kyllikki/SAP/sap.pdf

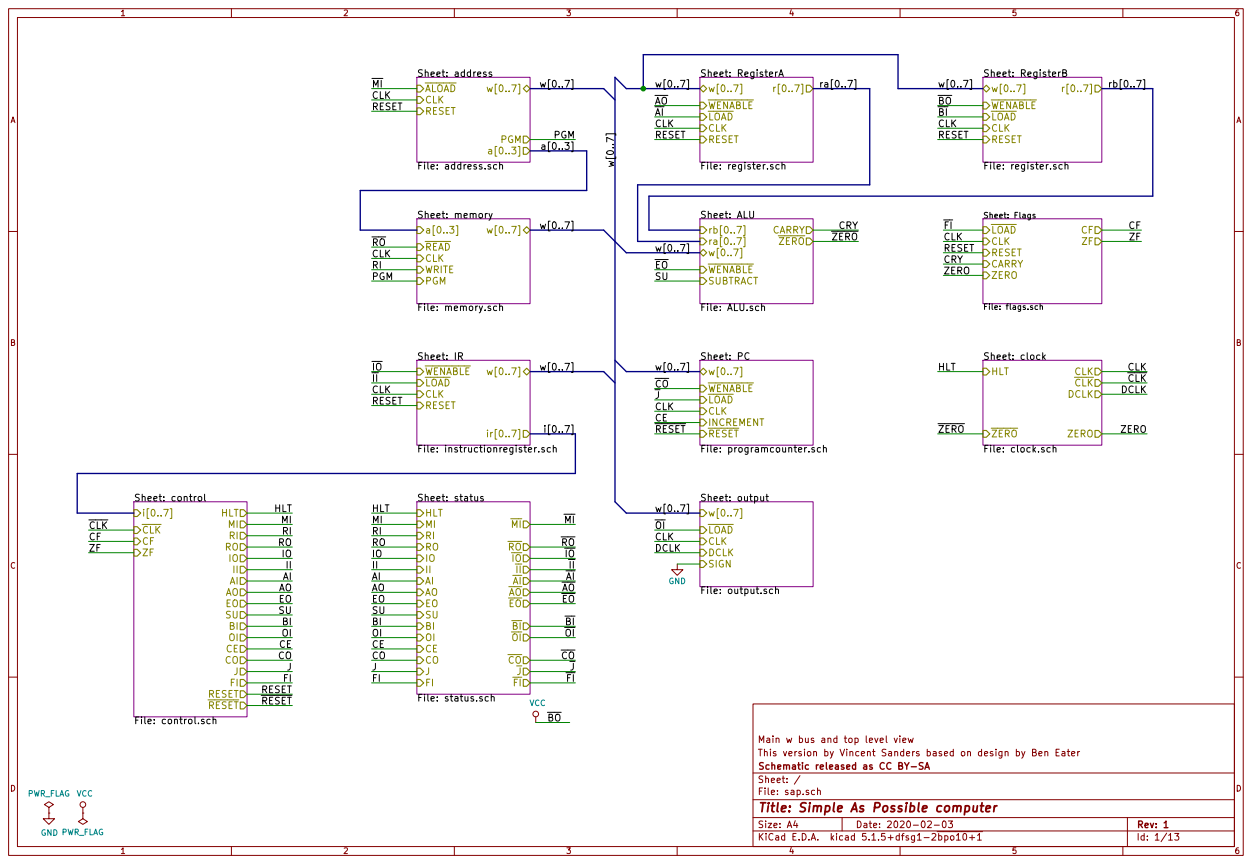
[picture p1: page 1]

Sheet: address File: address.sch w[0..7]
ALOAD
CLK
RESET

ZF Sheet: ALU
File: ALU.sch SUBTRACT WENABLE w[0..7]

Sheet: control File: control.sch CLK

Main w bus and top level view
This version by Vincent Sanders based on design by Ben Eater
File: sap.sch Sheet: / Schematic released as CC BY-SA

Id: 1/13 Title: Simple As Possible computer

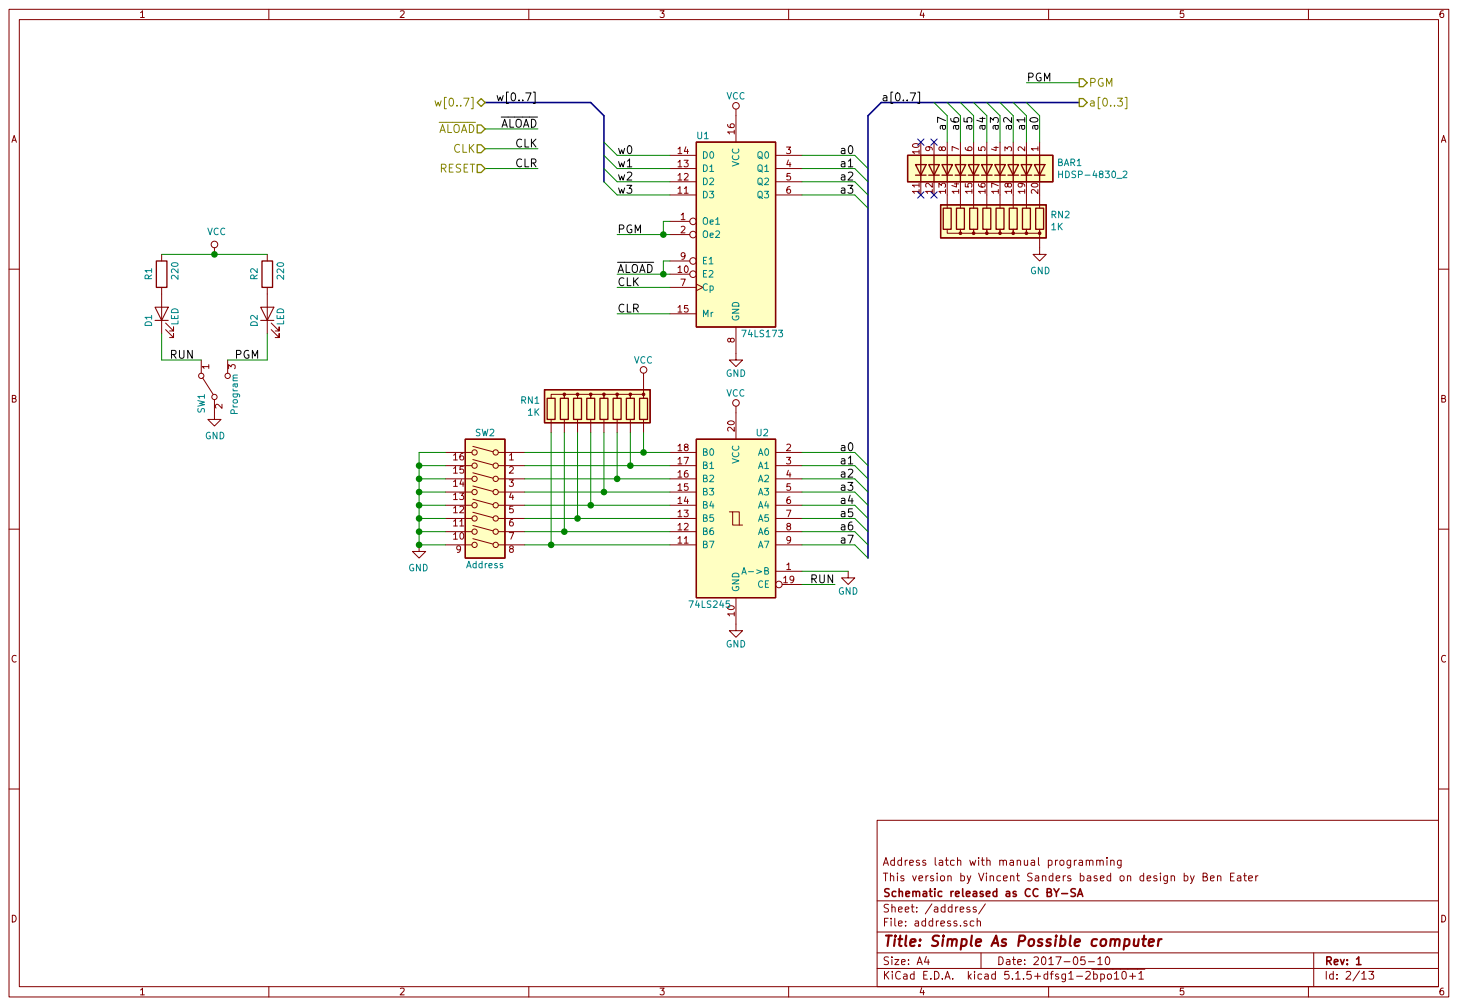
[picture p2: page 2]

Address latch with manual programming GND

This version by Vincent Sanders based on design by Ben Eater
Id: 2/13 Title: Simple As Possible computer File: address.sch Sheet: /address/ Schematic released as CC BY-SA

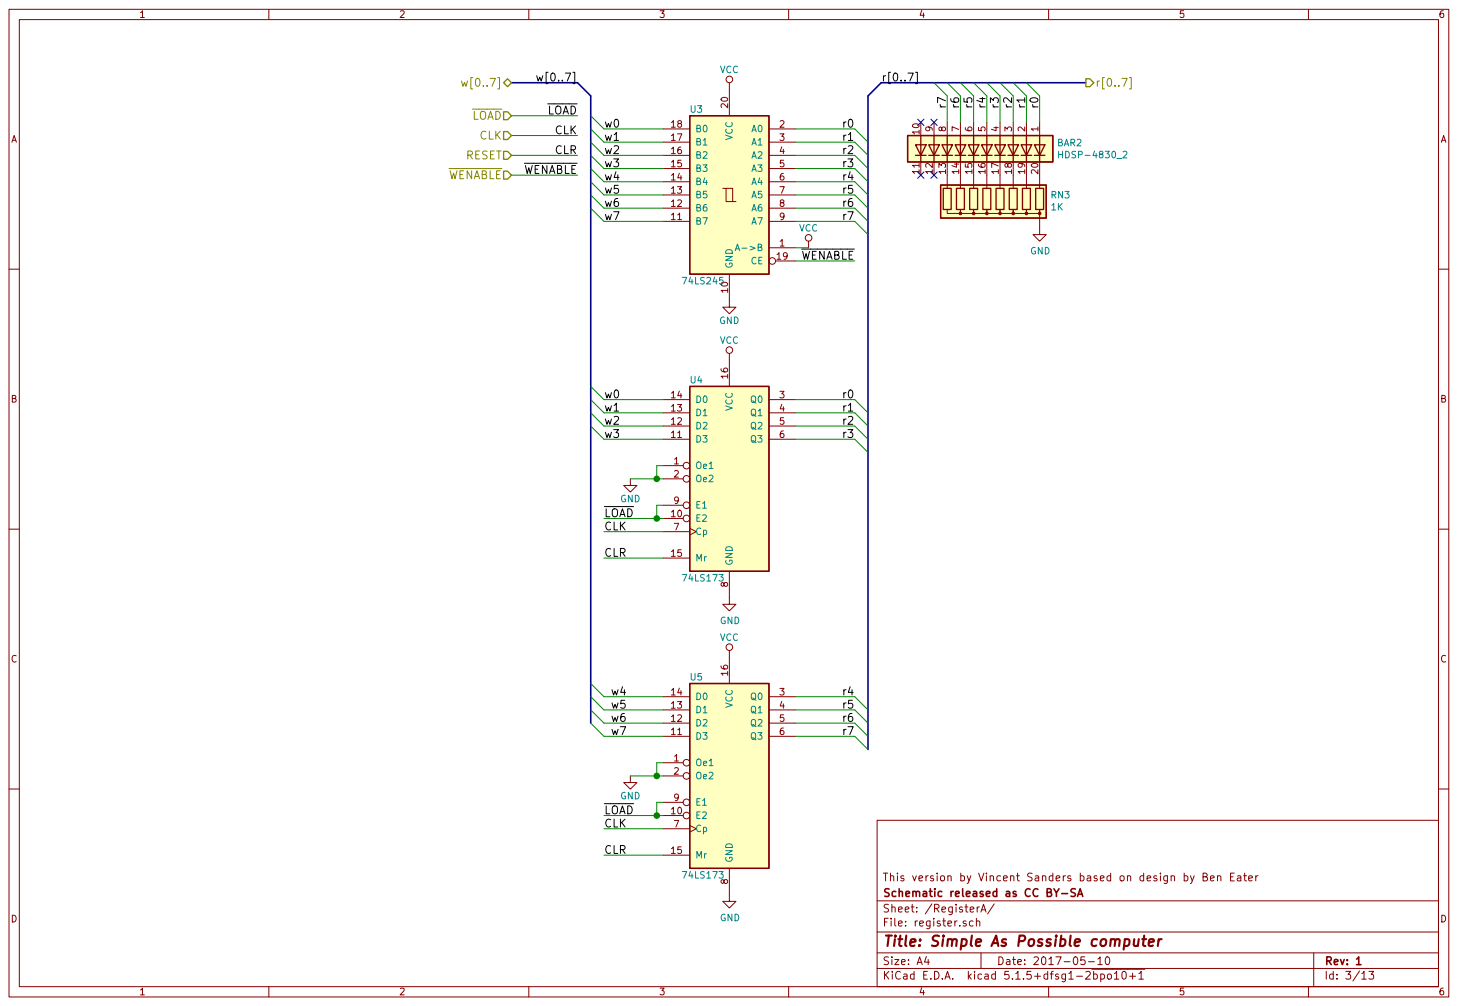
[picture p3: page 3]

Sheet: /RegisterA/ Schematic released as CC BY-SA

File: register.sch
Id: 3/13 Title: Simple As Possible computer

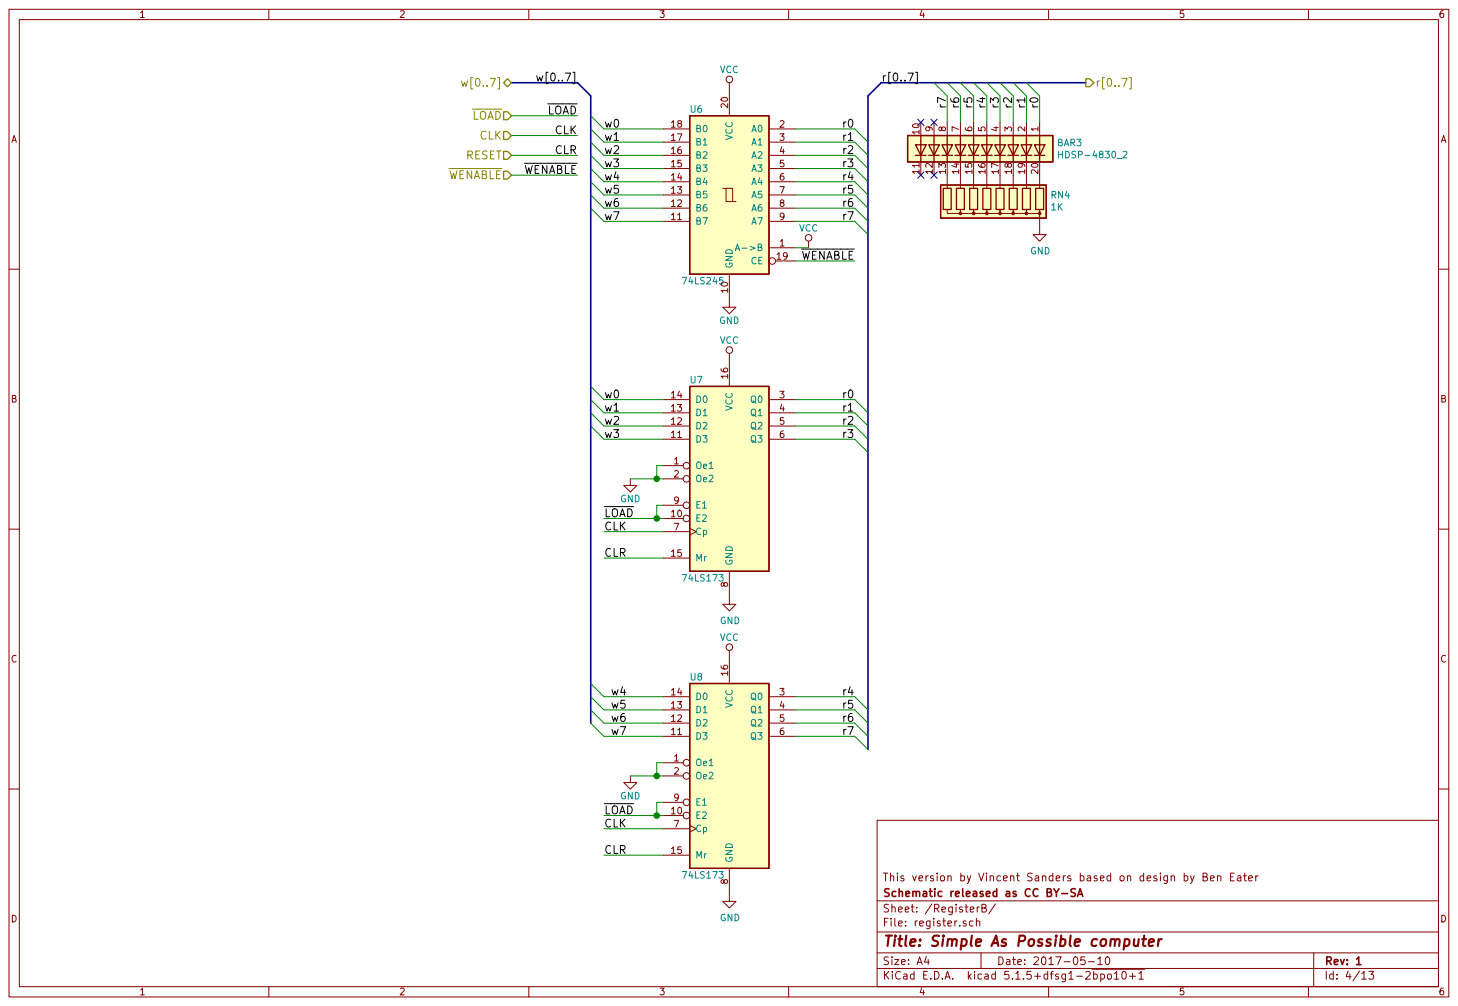
[picture p4: page 4]

Sheet: /RegisterB/ Schematic released as CC BY-SA

File: register.sch
Id: 4/13 Title: Simple As Possible computer

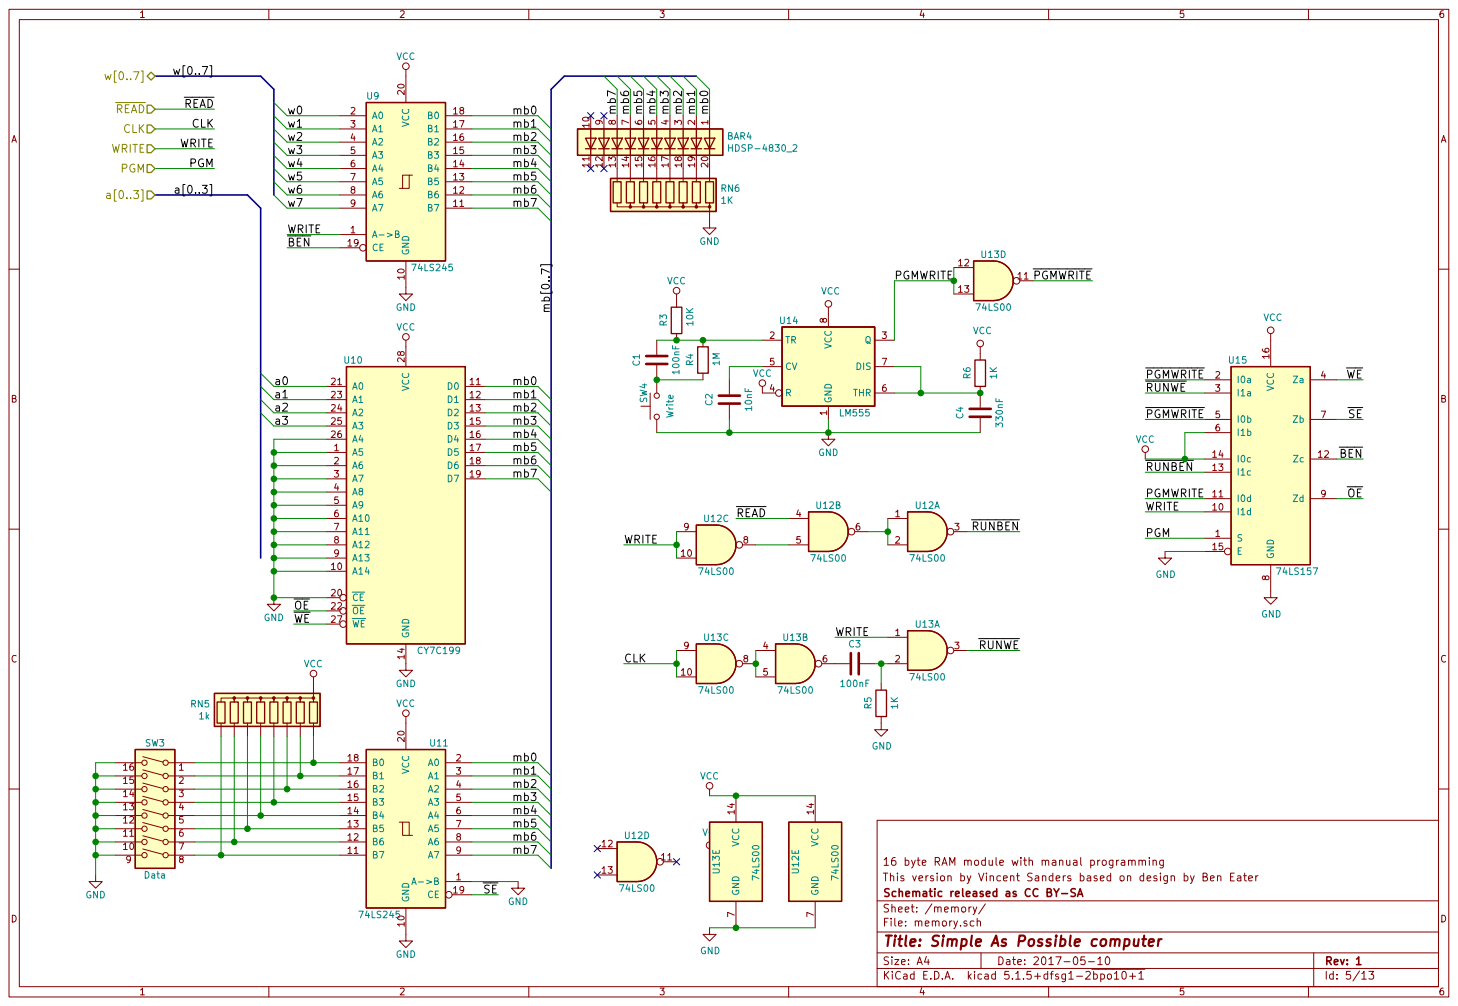
[picture p5: page 5]

This version by Vincent Sanders based on design by Ben Eater
Sheet: /memory/ Schematic released as CC BY-SA

File: memory.sch
Id: 5/13 Title: Simple As Possible computer

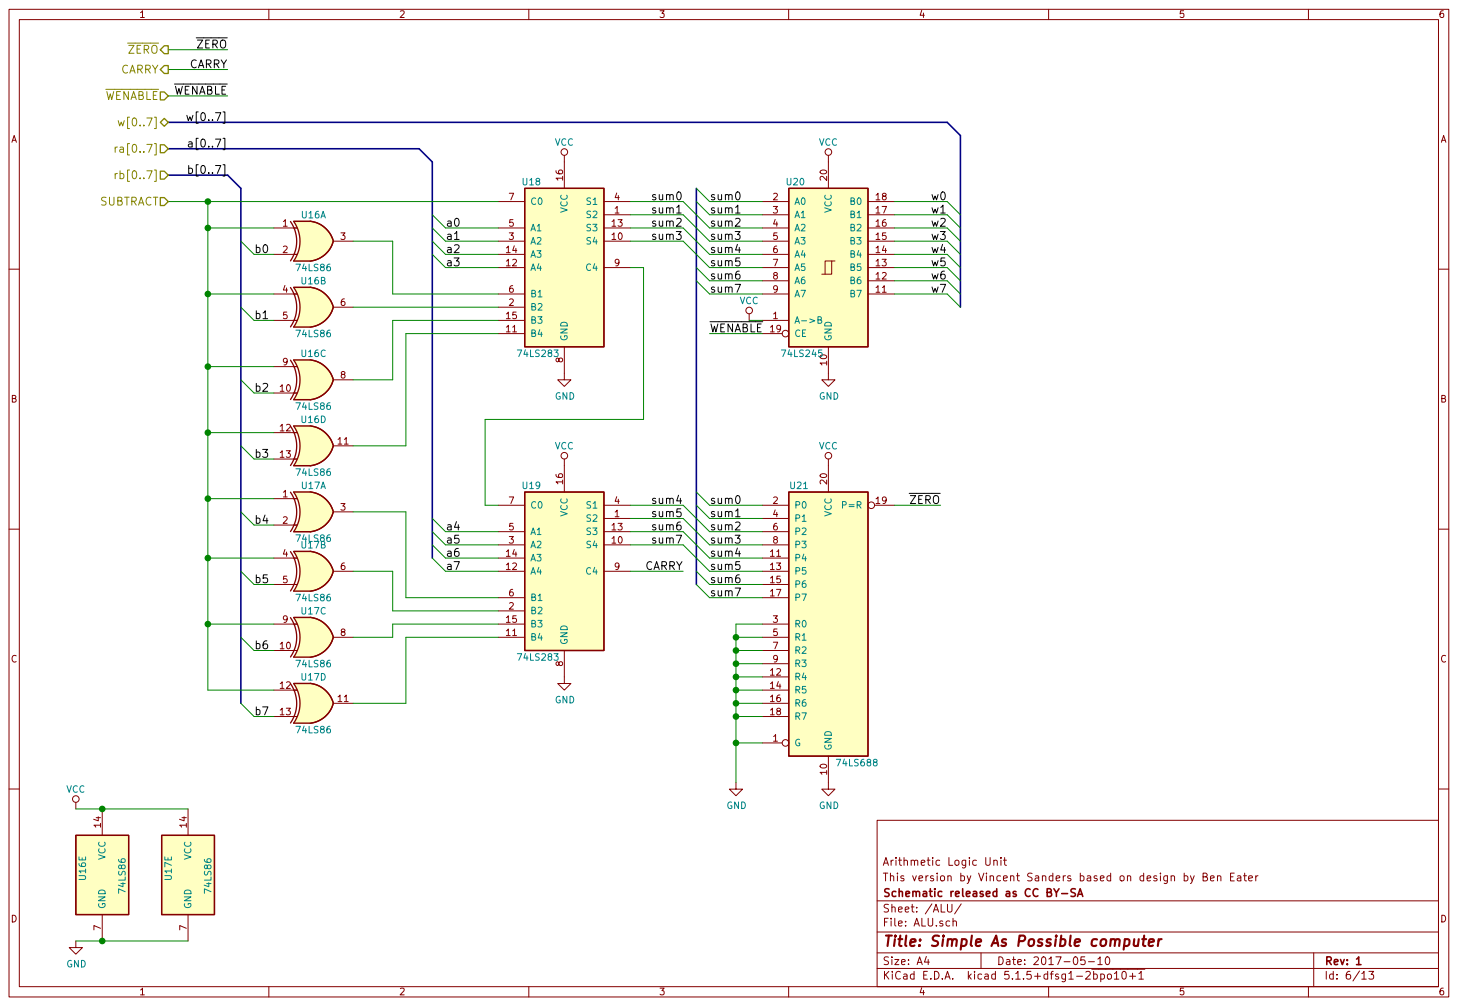
[picture p6: page 6]

This version by Vincent Sanders based on design by Ben Eater
Id: 6/13 Title: Simple As Possible computer File: ALU.sch Sheet: /ALU/ Schematic released as CC BY-SA

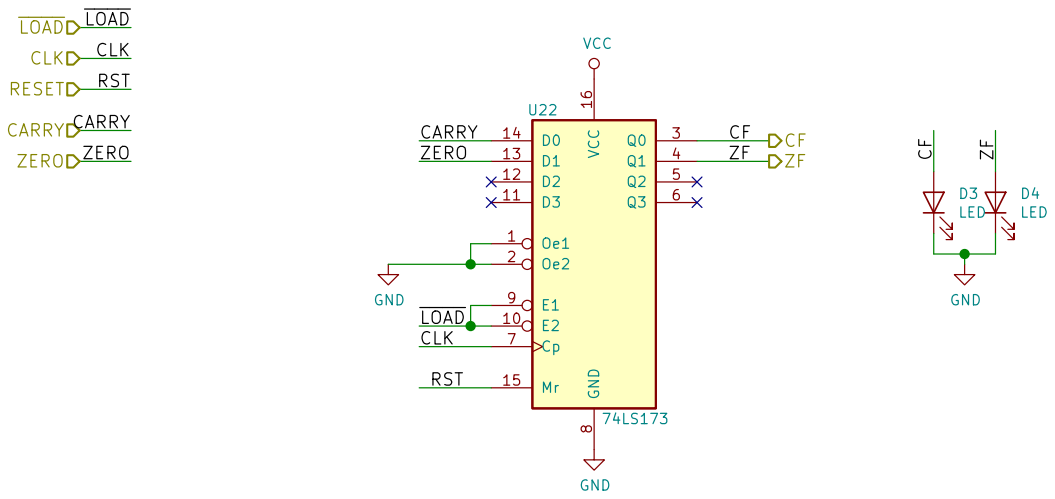
[picture p7: page 7]

Flags register
This version by Vincent Sanders based on design by Ben Eater
Sheet: /Flags/ Schematic released as CC BY-SA

File: flags.sch
Id: 7/13 Title: Simple As Possible computer

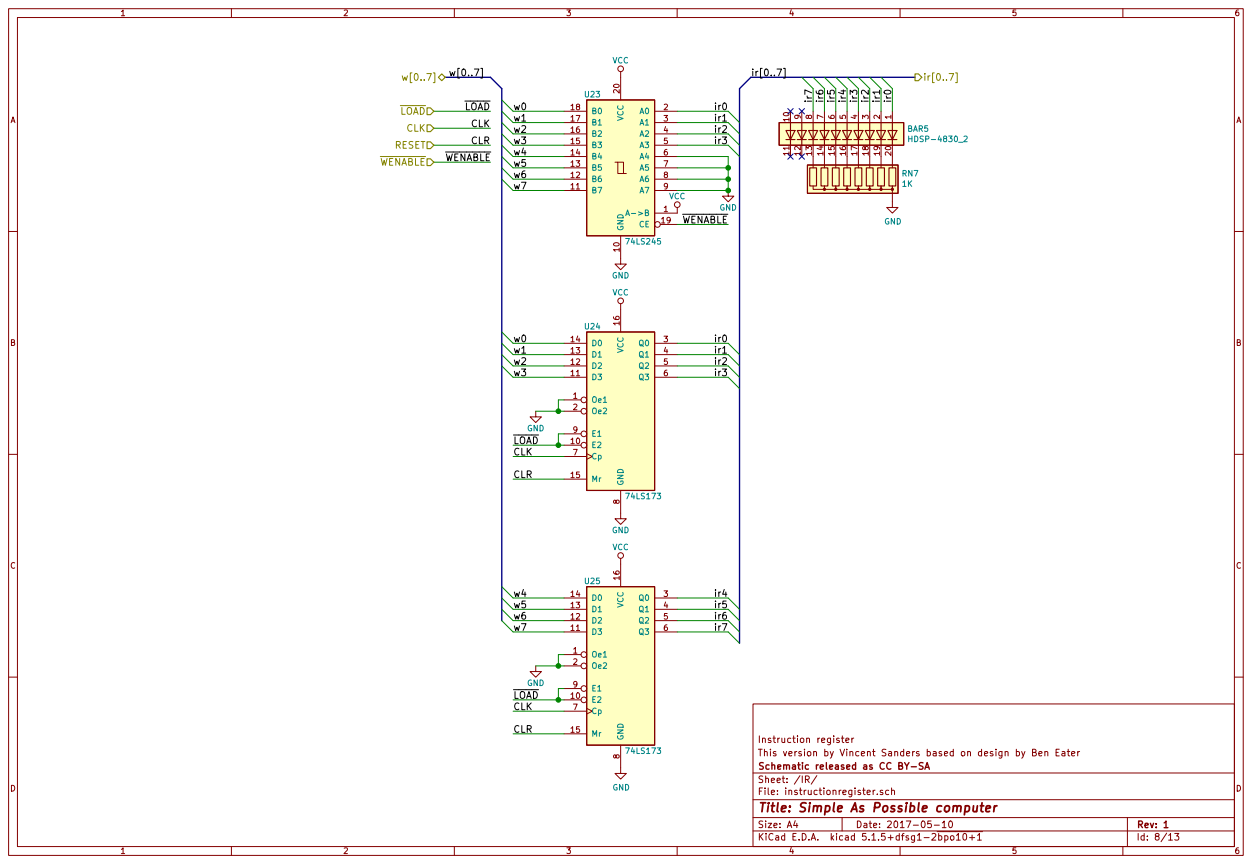
[picture p8: page 8]

Instruction register
This version by Vincent Sanders based on design by Ben Eater
File: instructionregister.sch Sheet: /IR/ Schematic released as CC BY-SA

Id: 8/13 Title: Simple As Possible computer

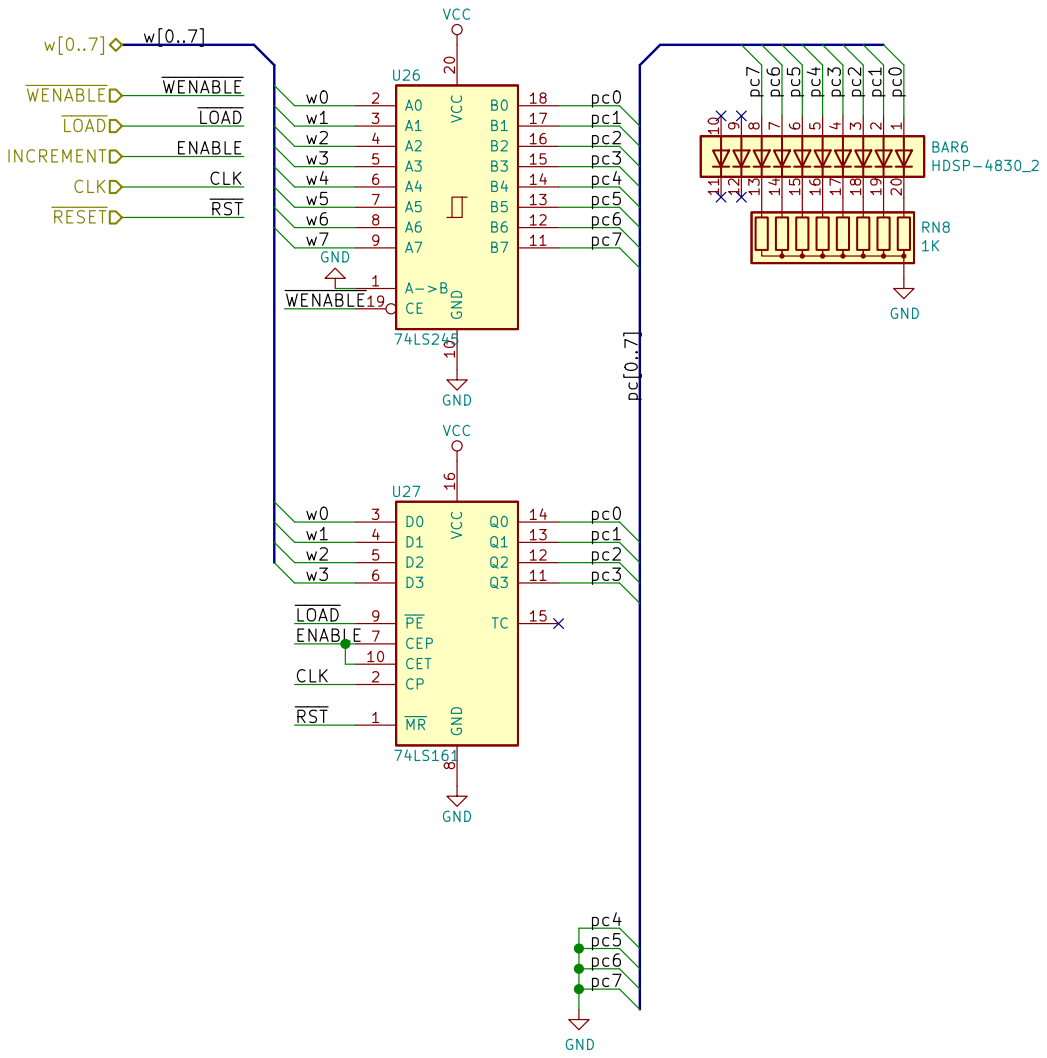
[picture p9: page 9]

Program counter
This version by Vincent Sanders based on design by Ben Eater
File: programcounter.sch Sheet: /PC/ Schematic released as CC BY-SA

Id: 9/13 Title: Simple As Possible computer

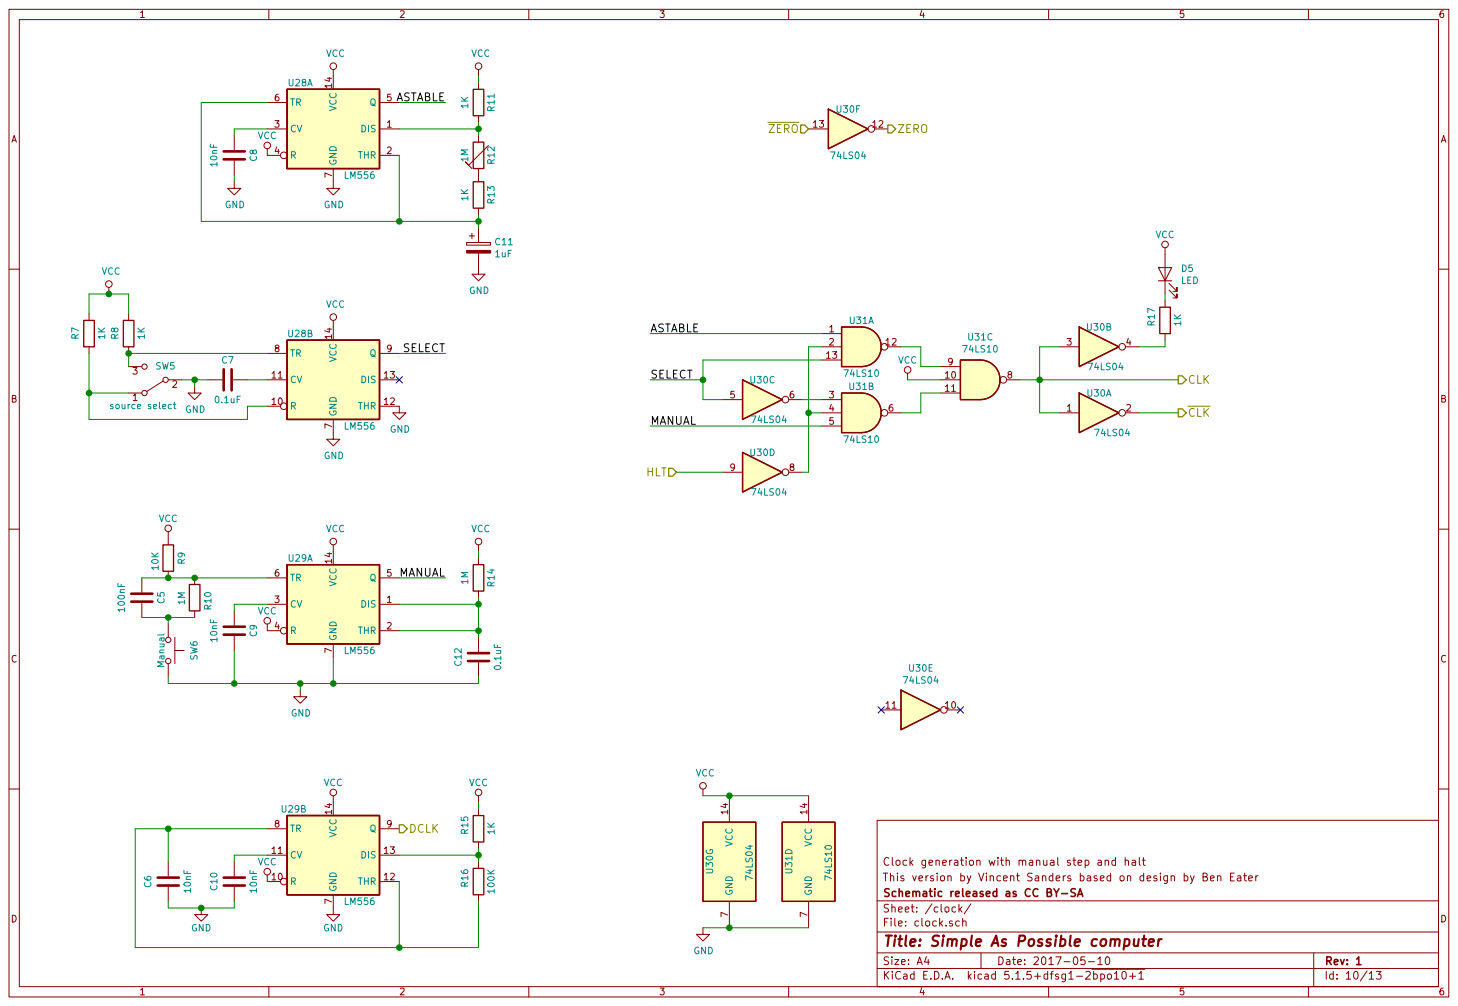
[picture p10: page 10]

SELECT MANUAL ASTABLE MANUAL SELECT

This version by Vincent Sanders based on design by Ben Eater
Id: 10/13 Title: Simple As Possible computer File: clock.sch Sheet: /clock/ Schematic released as CC BY-SA

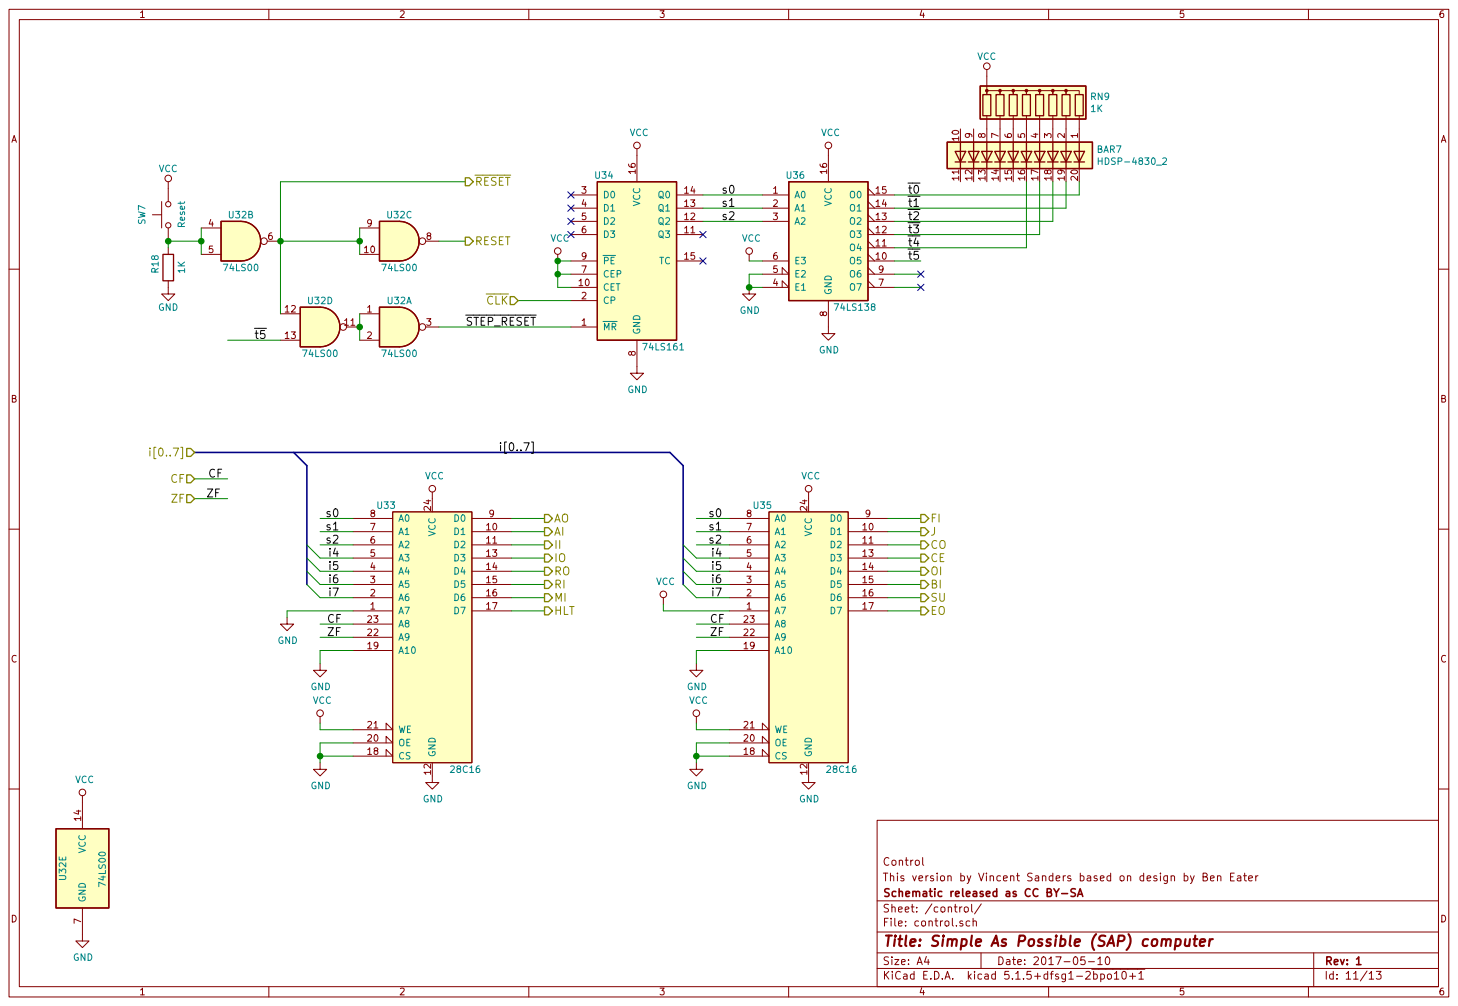
[picture p11: page 11]

Id: 11/13 Title: Simple As Possible (SAP) computer File: control.sch Sheet: /control/ Schematic released as CC BY-SA

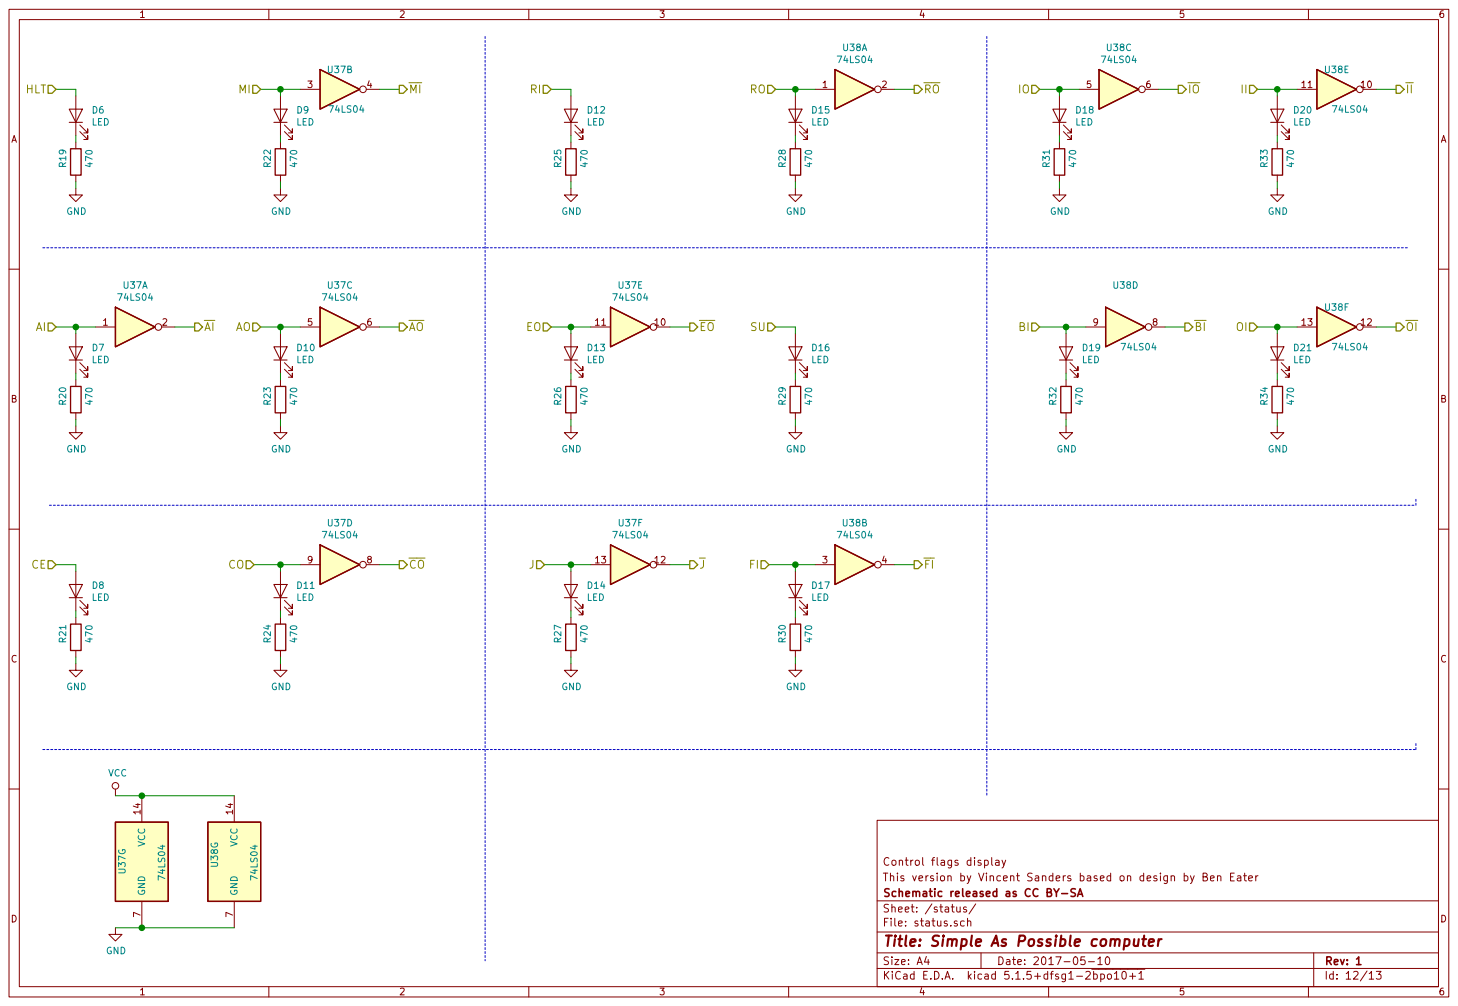
[picture p12: page 12]

7 U37G 74LS04 MI AO OI HLT MI RI RO RO IO IO II II AI AI AO EO EO SU

This version by Vincent Sanders based on design by Ben Eater
Id: 12/13 Title: Simple As Possible computer File: status.sch Sheet: /status/ Schematic released as CC BY-SA

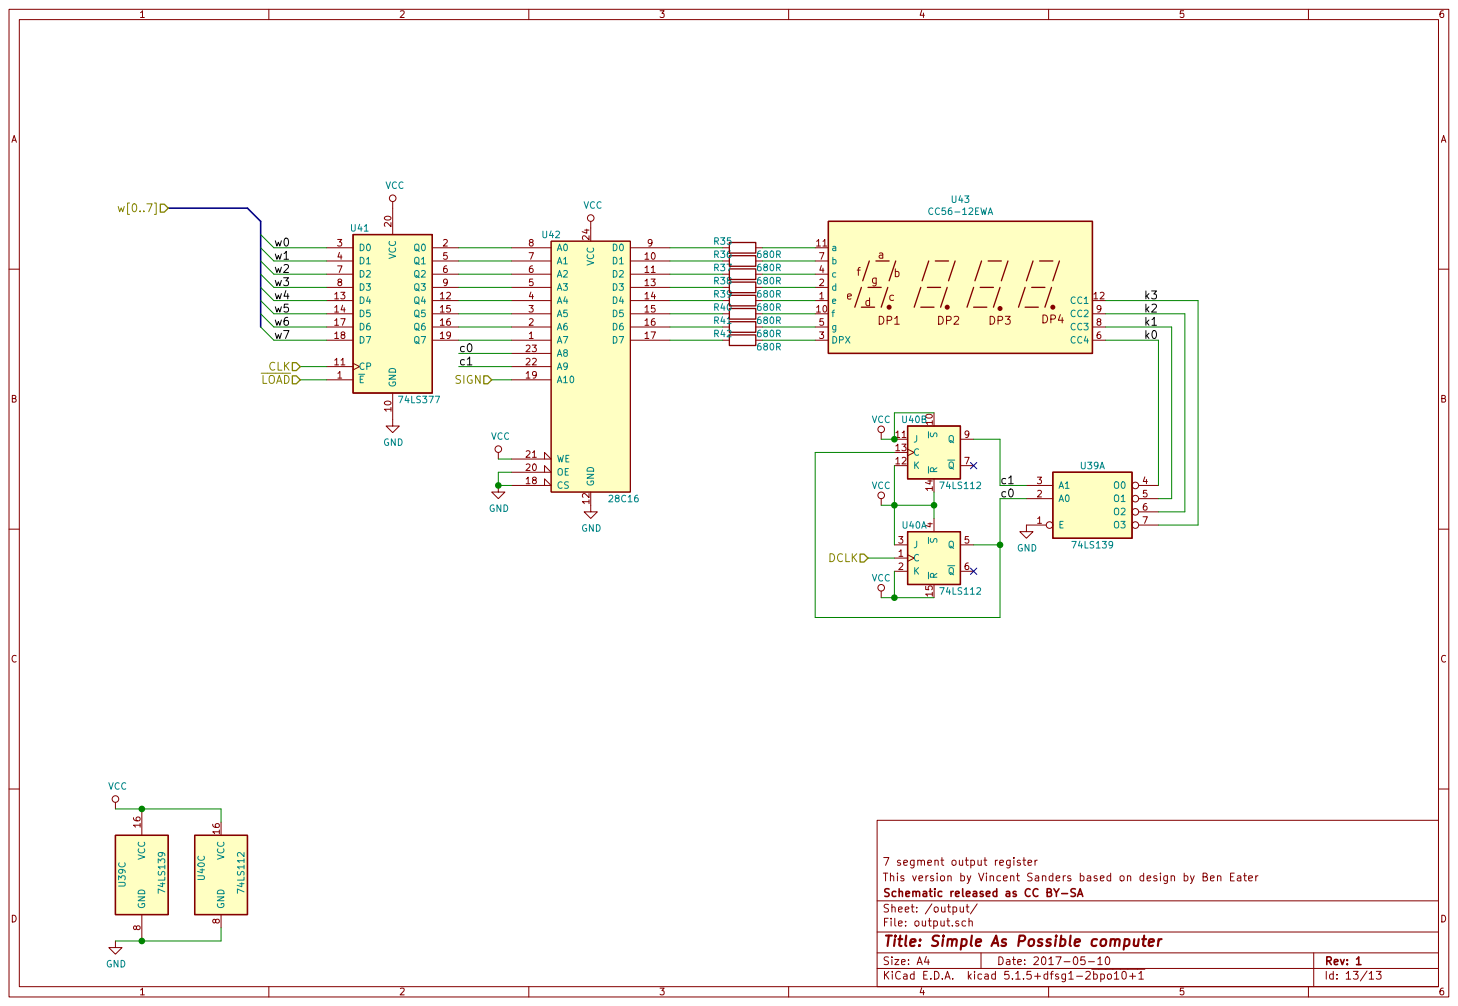
[picture p13: page 13]

k2
k1
k0

This version by Vincent Sanders based on design by Ben Eater
Sheet: /output/ Schematic released as CC BY-SA

File: output.sch
Id: 13/13 Title: Simple As Possible computer
