kyllikki/SAP/kicad/ALU.sch

## KiCad design kicad/ALU.sch (2020-02-08)

Schematic: ALU.sch

Parts:
U16, U17: 74LS86
U18, U19: 74LS283
U20: 74LS245
U21: 74LS688
