kyllikki/SAP/kicad/address.sch

## KiCad design kicad/address.sch (2020-02-08)

Schematic: address.sch

Parts:
BAR1: HDSP-4830_2; HDSP-4830
D1, D2: LED
R1, R2: 220
RN1, RN2: 1K; R_Array_SIP9
SW1: Program
SW2: Address
U1: 74LS173
U2: 74LS245
