kyllikki/SAP/kicad/clock.sch

## KiCad design kicad/clock.sch (2020-02-08)

Schematic: clock.sch

Parts:
C5: 100nF
C6, C8, C9, C10: 10nF
C7, C12: 0.1uF
C11: 1uF
D5: LED
R7, R8, R11, R13, R15, R17: 1K
R9: 10K
R10, R12, R14: 1M
R16: 100K
SW5: source select
SW6: Manual
U28, U29: LM556
U30: 74LS04
U31: 74LS10
