kyllikki/SAP/kicad/control.sch

## KiCad design kicad/control.sch (2020-02-08)

Schematic: control.sch

Parts:
BAR7: HDSP-4830_2; HDSP-4830
R18: 1K
RN9: 1K; R_Array_SIP9
SW7: Reset
U32: 74LS00
U33, U35: 28C16
U34: 74LS161
U36: 74LS138
