kyllikki/SAP/kicad/flags.sch

## KiCad design kicad/flags.sch (2020-02-08)

Schematic: flags.sch

Parts:
D3, D4: LED
U22: 74LS173
