kyllikki/SAP/kicad/instructionregister.sch

## KiCad design kicad/instructionregister.sch (2020-02-08)

Schematic: instructionregister.sch

Parts:
BAR5: HDSP-4830_2; HDSP-4830
RN7: 1K; R_Array_SIP9
U23: 74LS245
U24, U25: 74LS173
