kyllikki/SAP/kicad/memory.sch

## KiCad design kicad/memory.sch (2020-02-08)

Schematic: memory.sch

Parts:
BAR4: HDSP-4830_2; HDSP-4830
C1, C3: 100nF
C2: 10nF
C4: 330nF
R3: 10K
R4: 1M
R5, R6: 1K
RN5: 1k; R_Array_SIP9
RN6: 1K; R_Array_SIP9
SW3: Data
SW4: Write
U9, U11: 74LS245
U10: CY7C199
U12, U13: 74LS00
U14: LM555
U15: 74LS157
