kyllikki/SAP/kicad/output.sch

## KiCad design kicad/output.sch (2020-02-08)

Schematic: output.sch

Parts:
R35, R36, R37, R38, R39, R40, R41, R42: 680R
U39: 74LS139
U40: 74LS112
U41: 74LS377
U42: 28C16
U43: CC56-12EWA; CA56-12EWA
