kyllikki/SAP/kicad/programcounter.sch

## KiCad design kicad/programcounter.sch (2020-02-08)

Schematic: programcounter.sch

Parts:
BAR6: HDSP-4830_2; HDSP-4830
RN8: 1K; R_Array_SIP9
U26: 74LS245
U27: 74LS161
