kyllikki/SAP/kicad/register.sch

## KiCad design kicad/register.sch (2020-02-08)

Schematic: register.sch

Parts:
BAR2: HDSP-4830_2; HDSP-4830
RN3: 1K; R_Array_SIP9
U3: 74LS245
U4, U5: 74LS173
