kyllikki/SAP/kicad/status.sch

## KiCad design kicad/status.sch (2020-02-08)

Schematic: status.sch

Parts:
D6, D7, D8, D9, D10, D11, D12, D13, D14, D15, D16, D17, D18, D19, D20, D21: LED
R19, R20, R21, R22, R23, R24, R25, R26, R27, R28, R29, R30, R31, R32, R33, R34: 470
U37, U38: 74LS04
