kyllikki/SAP/(commit log)

2018-07-24 Ben eaters original design
    [ALU.sch, clock.sch, control.sch, flags.sch, instructionregister.sch, memory.sch, output.sch, programcounter.sch]
2018-07-24 bugfixed design
    [ALU.sch, clock.sch, control.sch, flags.sch, instructionregister.sch, memory.sch, output.sch, programcounter.sch]
2018-07-24 design as built
    [ALU.sch, clock.sch, control.sch, flags.sch, instructionregister.sch, memory.sch, output.sch, programcounter.sch]
2020-02-08 Update to current kicad version
    [ALU.sch, address.sch, clock.sch, control.sch, flags.sch, instructionregister.sch, memory.sch, output.sch]
